AlexSlayer0/Temp_Sensor2/README.md

# Owners

Tobias Zimmerman und Alexander Schiechtl
