AlexSlayer0/Temp_Sensor2/RaumluftsensorC3/RaumluftsensorC3.step

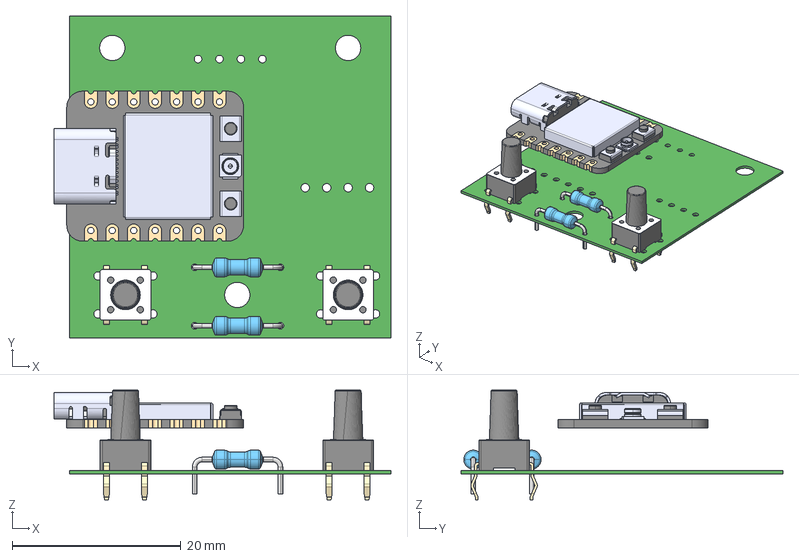
[picture p15: CAD file, 2025-05-07]
RaumluftsensorC3/RaumluftsensorC3.step
39.9 x 38.1 x 13.0 mm
SW3dPS-resistor_-_fixed x 2
XIAO_ESP32C3--3DModel-STEP-269445
