AlexSlayer0/Temp_Sensor2/RaumluftsensorC3Gehaeuse/Deckel.stp

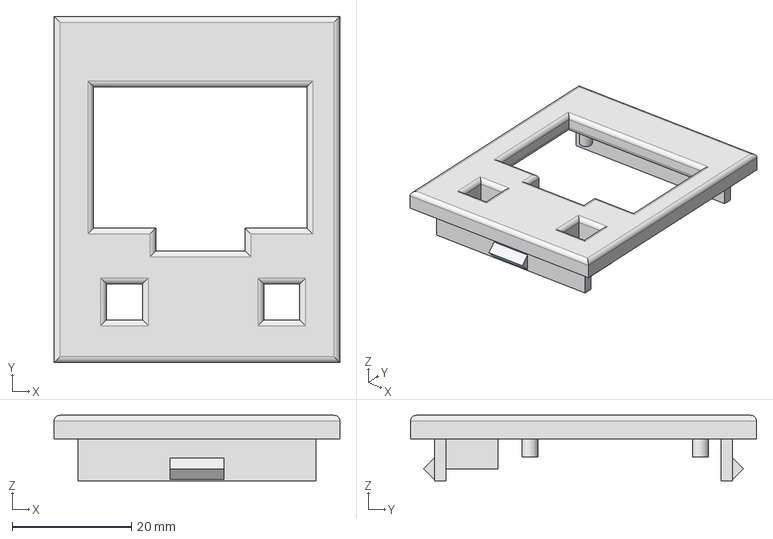
[picture p16: CAD file, 2025-05-07]
RaumluftsensorC3Gehaeuse/Deckel.stp
48.0 x 58.1 x 11.0 mm
