AlexSlayer0/Temp_Sensor2/RaumluftsensorC3Gehaeuse/Taster.stp

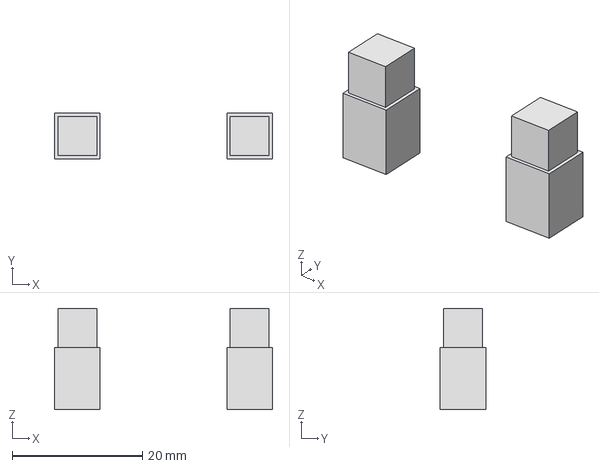
[picture p17: CAD file, 2025-05-07]
RaumluftsensorC3Gehaeuse/Taster.stp
33.4 x 7.00 x 15.5 mm
