AlexSlayer0/Temp_Sensor2/RaumluftsensorC3Gehaeuse/Unterseite.stp

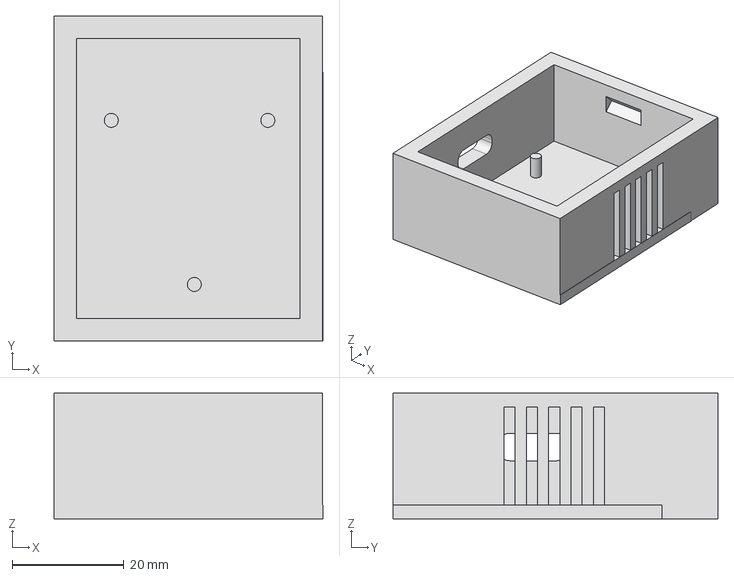
[picture p18: CAD file, 2025-05-07]
RaumluftsensorC3Gehaeuse/Unterseite.stp
48.1 x 58.1 x 22.5 mm
