AlexSlayer0/Temp_Sensor2/(list of files, cad)

Other CAD files:
RaumluftsensorC3Gehaeuse/Raumluftsensor.dwg
RaumluftsensorC3Gehaeuse/Deckel.ipt
RaumluftsensorC3Gehaeuse/Deckel.stl
RaumluftsensorC3Gehaeuse/OldVersions/Deckel.0004.ipt
RaumluftsensorC3Gehaeuse/OldVersions/Raumluftsensor.0008.iam
RaumluftsensorC3Gehaeuse/OldVersions/Unterseite.0015.ipt
RaumluftsensorC3Gehaeuse/Raumluftsensor.iam
RaumluftsensorC3Gehaeuse/RaumluftsensorC3.ipt
RaumluftsensorC3Gehaeuse/Taster.ipt
RaumluftsensorC3Gehaeuse/Taster.stl
RaumluftsensorC3Gehaeuse/Unterseite.ipt
RaumluftsensorC3Gehaeuse/Unterseite.stl
