AlexSlayer0/Temp_Sensor2/RaumluftsensorC3/Project Outputs for RaumluftsensorC3/altium-printoutsV1.5.PDF

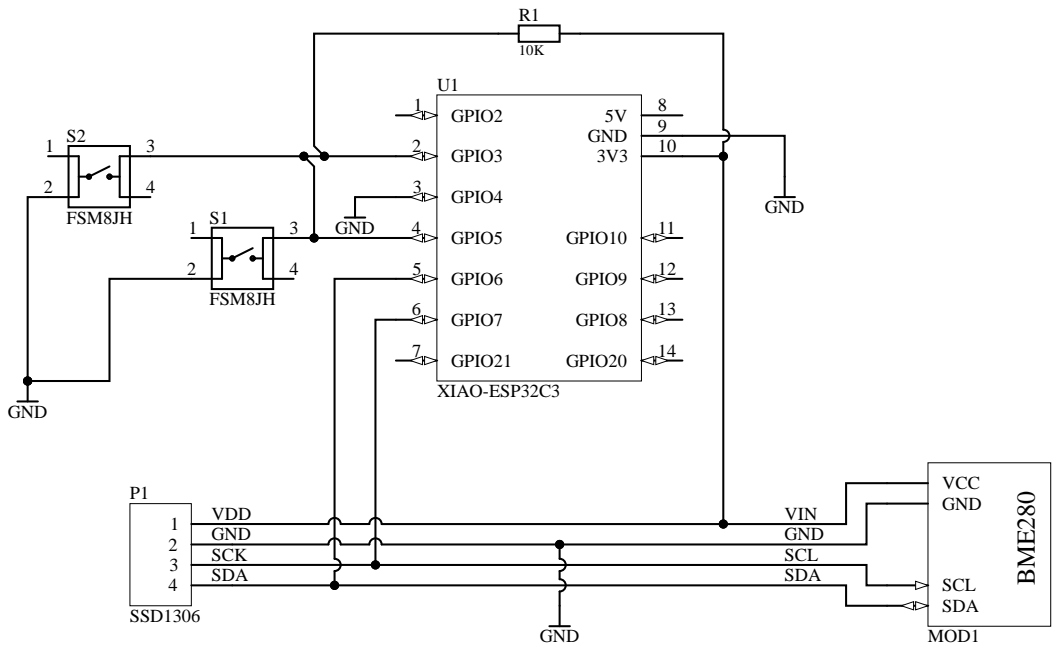
[picture p19: page 1]

GND | GND
SCK | SCL

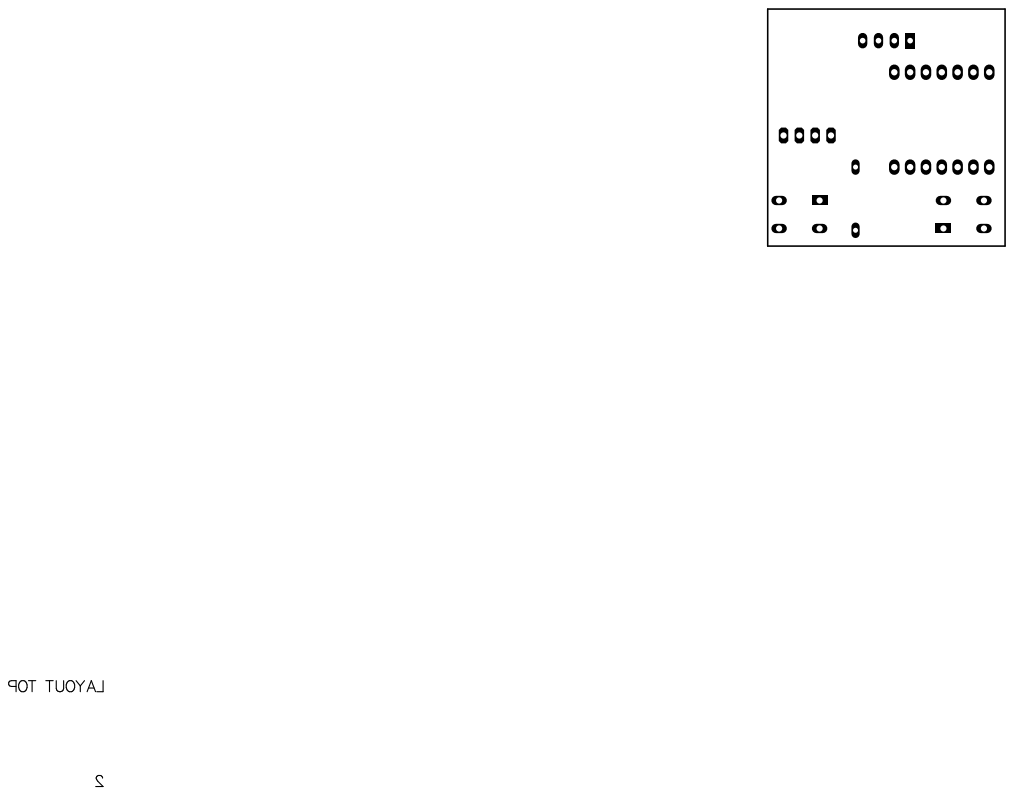
[picture p20: page 2]

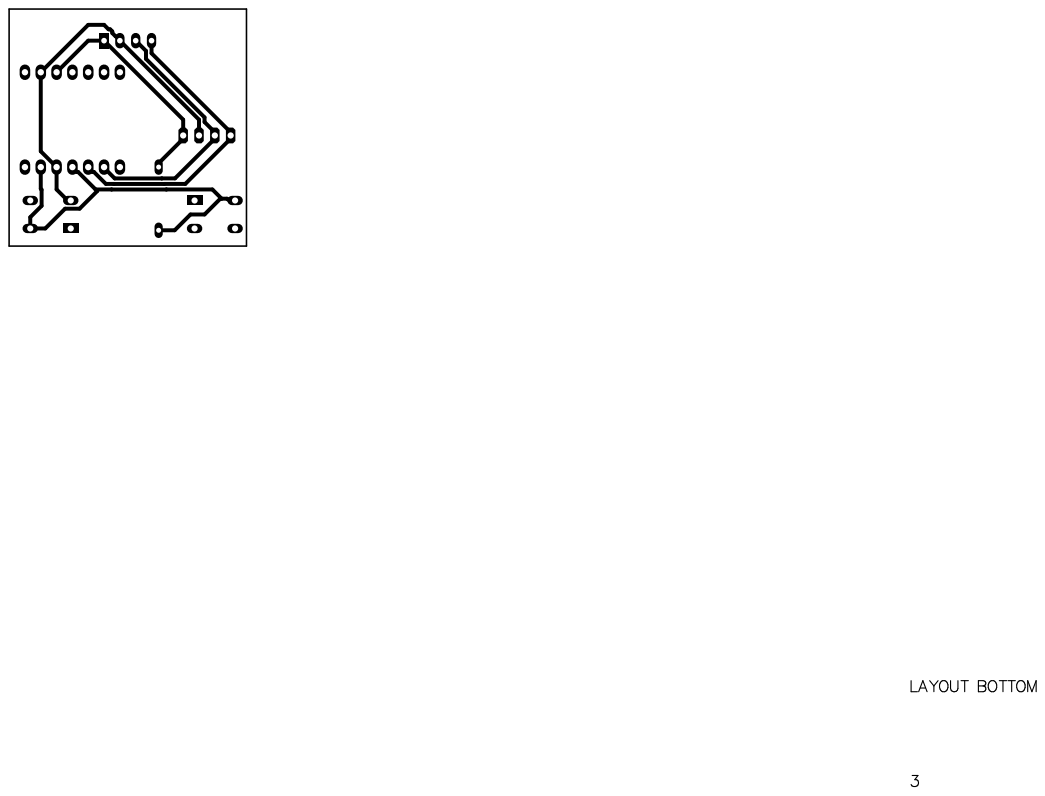
[picture p21: page 3]

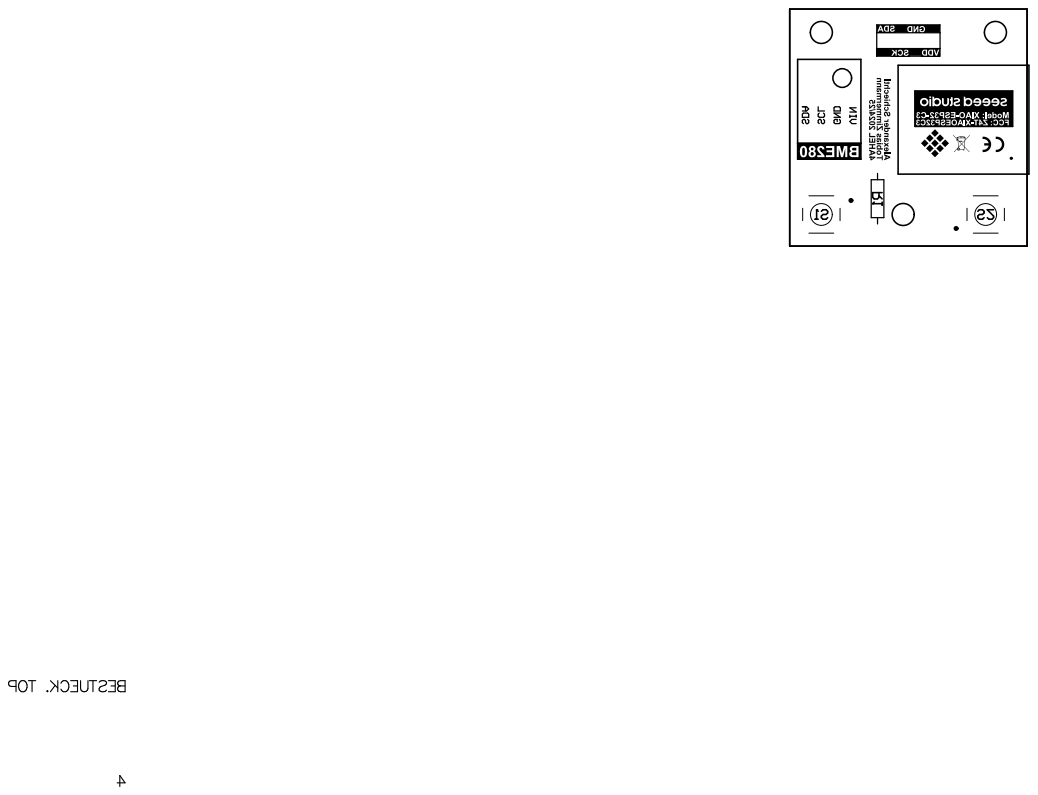
[picture p22: page 4]

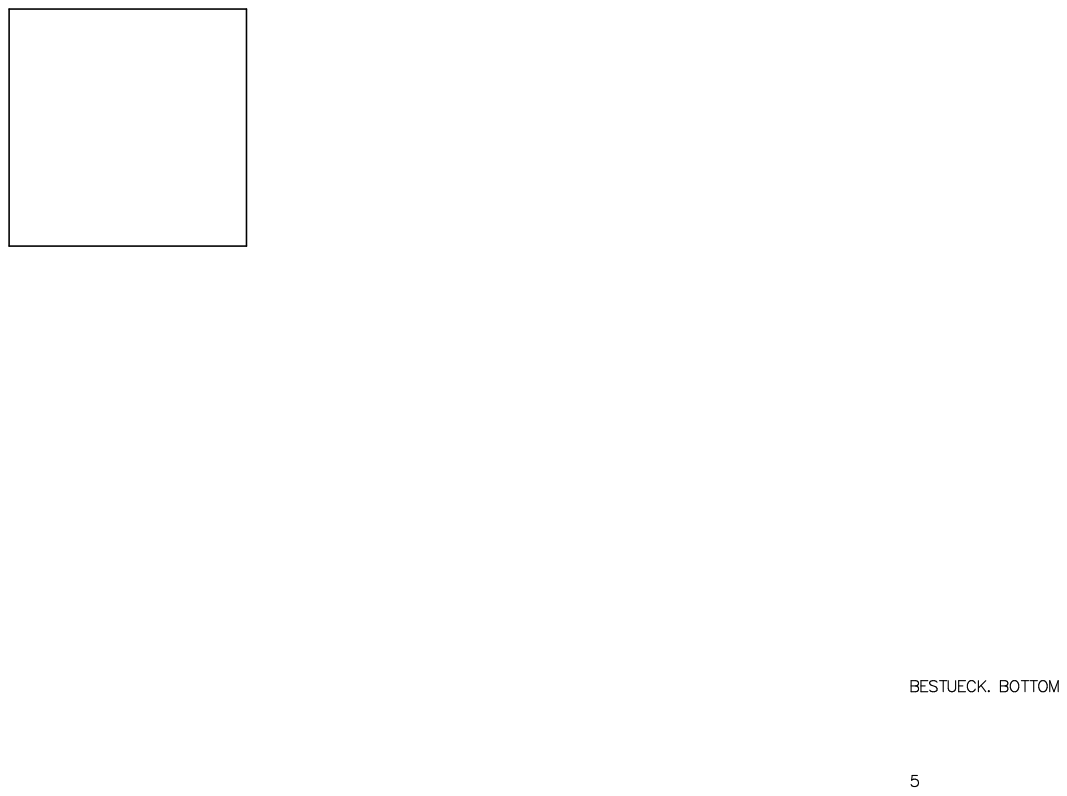
[picture p23: page 5]

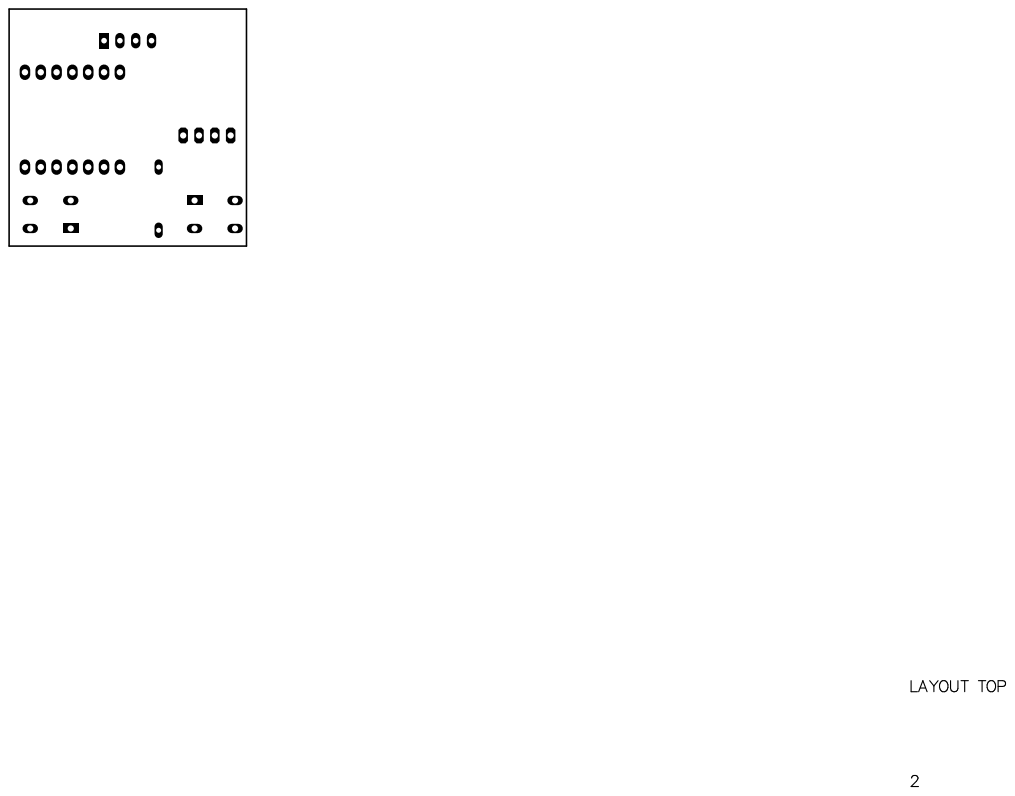
[picture p24: page 6]

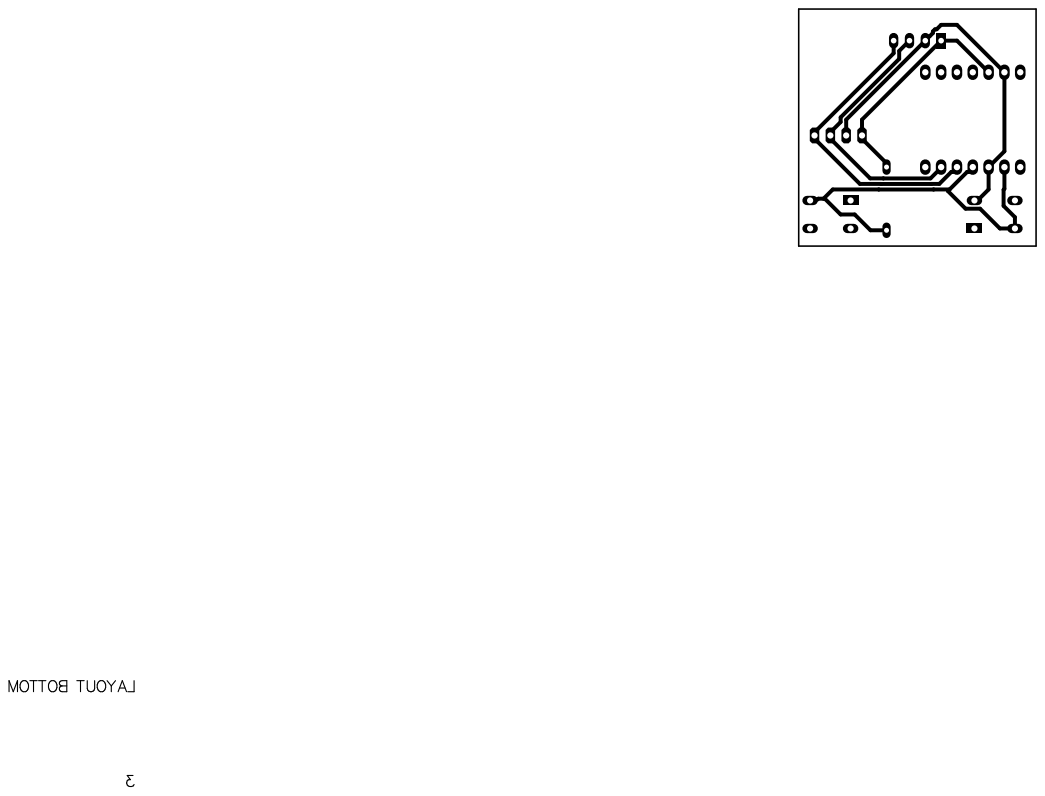
[picture p25: page 7]

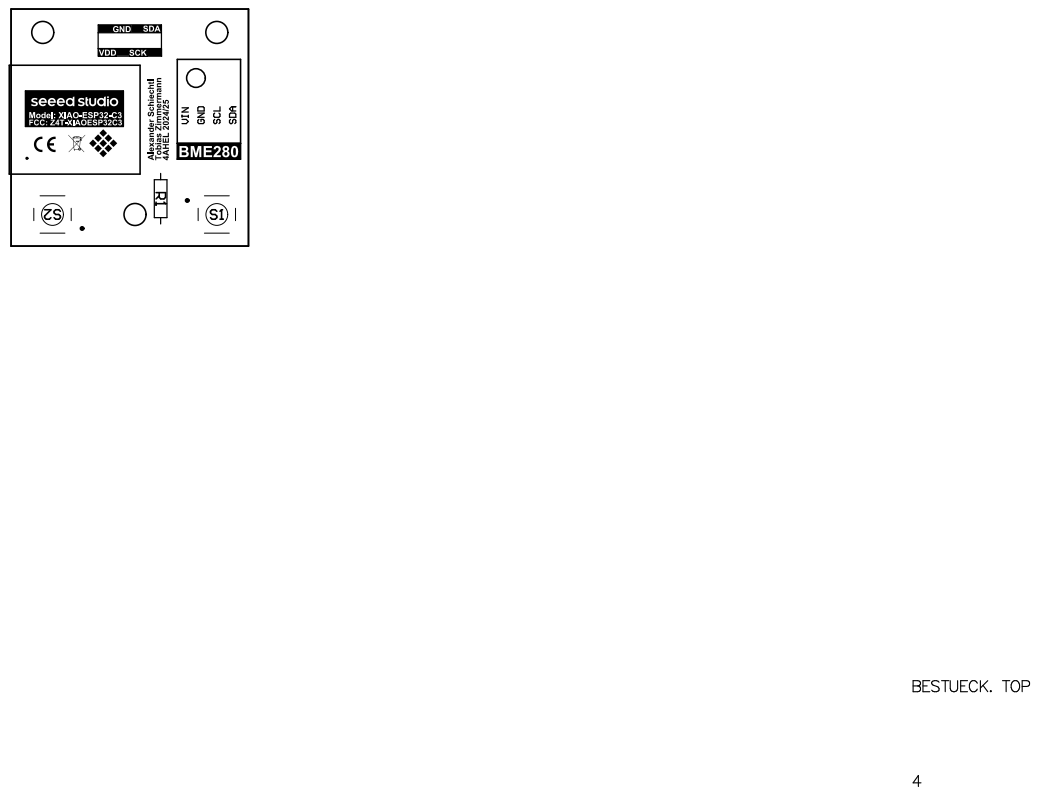
[picture p26: page 8]

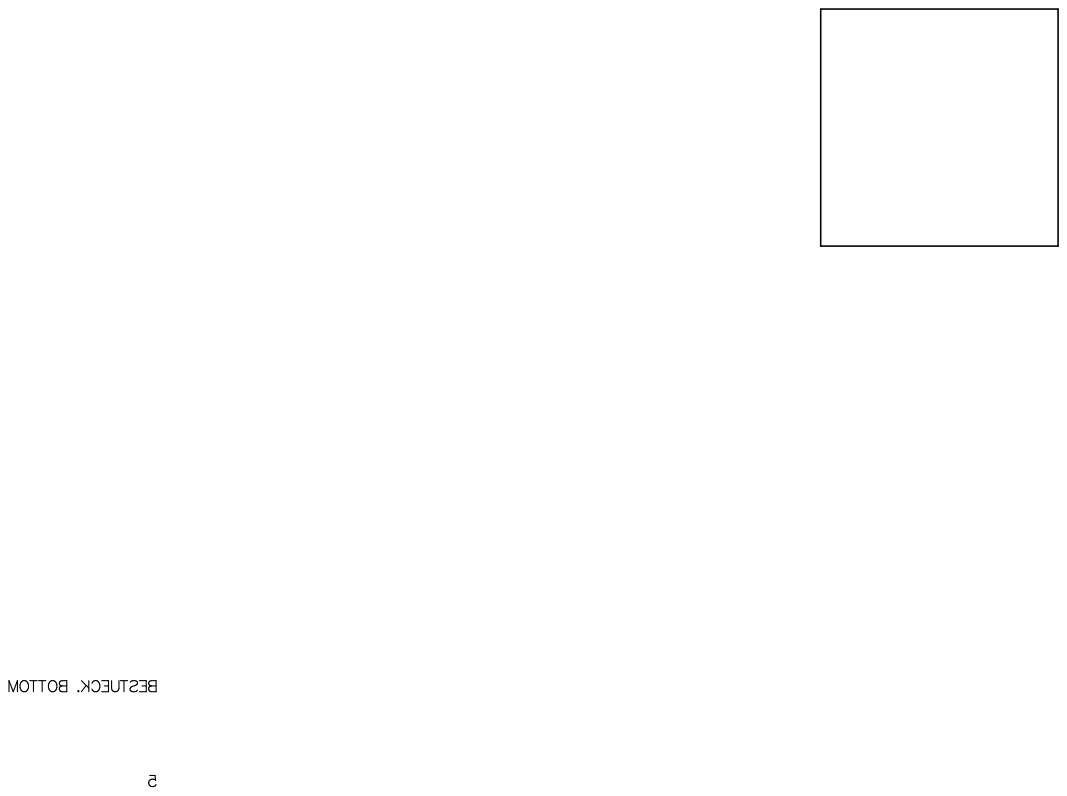
[picture p27: page 9]

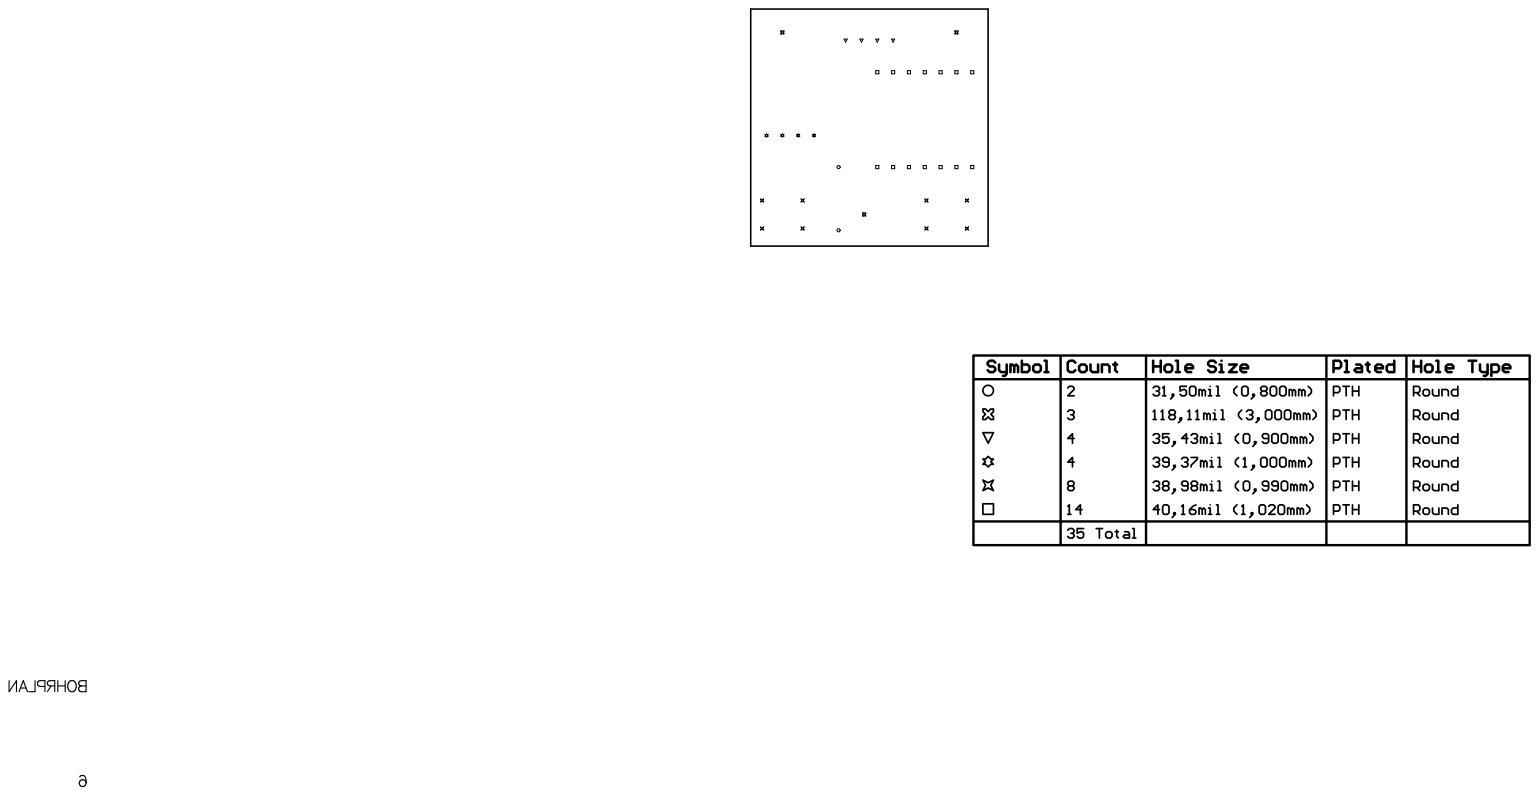
[picture p28: page 10]
