AlexSlayer0/Temp_Sensor2/(list of files, drawings)

Other design files:
RaumluftsensorC3/RaumluftsensorC3.PcbDoc
RaumluftsensorC3/RaumluftsensorC3.PrjPcb
RaumluftsensorC3/RaumluftsensorC3.SchDoc
