AlexSlayer0/Temp_Sensor2/(commit log)

2025-05-07 Pin Button
2025-05-07 Altium FIles
    [RaumluftsensorC3.PcbDoc, RaumluftsensorC3.PrjPcb, RaumluftsensorC3.SchDoc, RaumluftsensorC3.step]
2025-05-07 Gehäuse Files
    [Deckel.0004.ipt, Deckel.ipt, Deckel.stl, Deckel.stp, Raumluftsensor.0008.iam, Raumluftsensor.dwg, Raumluftsensor.iam, RaumluftsensorC3.ipt]
2025-05-07 Code FIX KP guat
    [main.cpp]
2025-05-07 Altium changes
    [RaumluftsensorC3.PcbDoc, RaumluftsensorC3.SchDoc]
